allanko/lasernet/lasernet/lasernet.runs/impl_1/.init_design.begin.rst

<?xml version="1.0"?>
<ProcessHandle Version="1" Minor="0">
    <Process Command=".planAhead." Owner="Allan" Host="ALLANKO" Pid="6456">
    </Process>
</ProcessHandle>
