allanko/lasernet/lasernet/lasernet.runs/impl_1/.vivado.begin.rst

<?xml version="1.0"?>
<ProcessHandle Version="1" Minor="0">
    <Process Command="vivado.bat" Owner="Allan" Host="ALLANKO" Pid="4016">
    </Process>
</ProcessHandle>
<?xml version="1.0"?>
<ProcessHandle Version="1" Minor="0">
    <Process Command="vivado.bat" Owner="Allan" Host="ALLANKO" Pid="7376">
    </Process>
</ProcessHandle>
