allanko/lasernet/lasernet/lasernet.ip_user_files/sim_scripts/clk_wiz_0/ies/file_info.txt

xpm_cdc.sv,systemverilog,xil_defaultlib,../../../../../Xilinx/Vivado/2016.3/data/ip/xpm/xpm_cdc/hdl/xpm_cdc.sv,incdir="$ref_dir/../../../ipstatic"incdir="../../../ipstatic"
xpm_VCOMP.vhd,vhdl,xpm,../../../../../Xilinx/Vivado/2016.3/data/ip/xpm/xpm_VCOMP.vhd,incdir="$ref_dir/../../../ipstatic"incdir="../../../ipstatic"
clk_wiz_0_clk_wiz.v,verilog,xil_defaultlib,../../../../lasernet.srcs/sources_1/ip/clk_wiz_0/clk_wiz_0_clk_wiz.v,incdir="$ref_dir/../../../ipstatic"incdir="../../../ipstatic"
clk_wiz_0.v,verilog,xil_defaultlib,../../../../lasernet.srcs/sources_1/ip/clk_wiz_0/clk_wiz_0.v,incdir="$ref_dir/../../../ipstatic"incdir="../../../ipstatic"
glbl.v,Verilog,xil_defaultlib,glbl.v
