allanko/lasernet/documentation/monitor-display.jpg

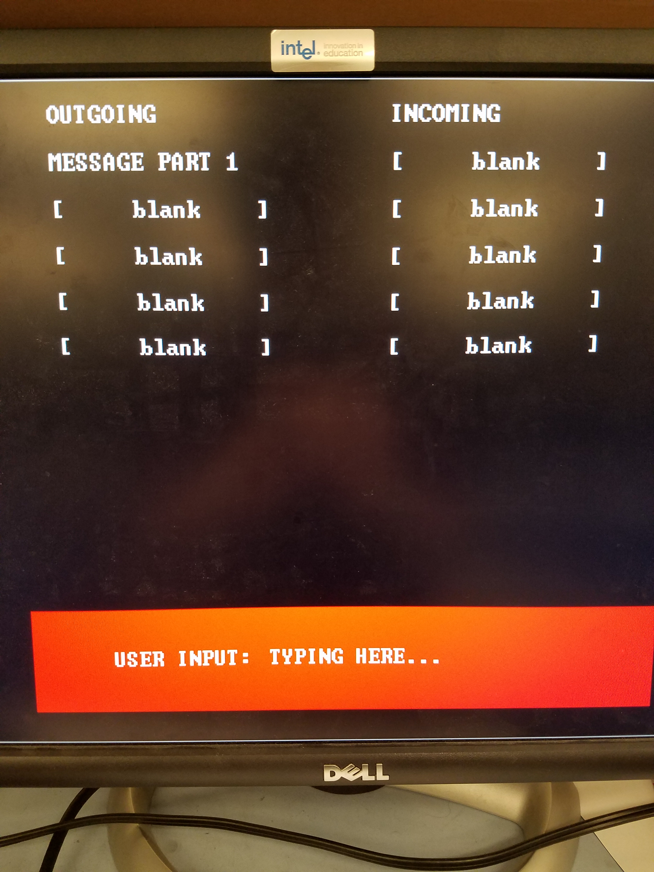
documentation/monitor-display.jpg
