allanko/lasernet/documentation/scratch-work.jpg

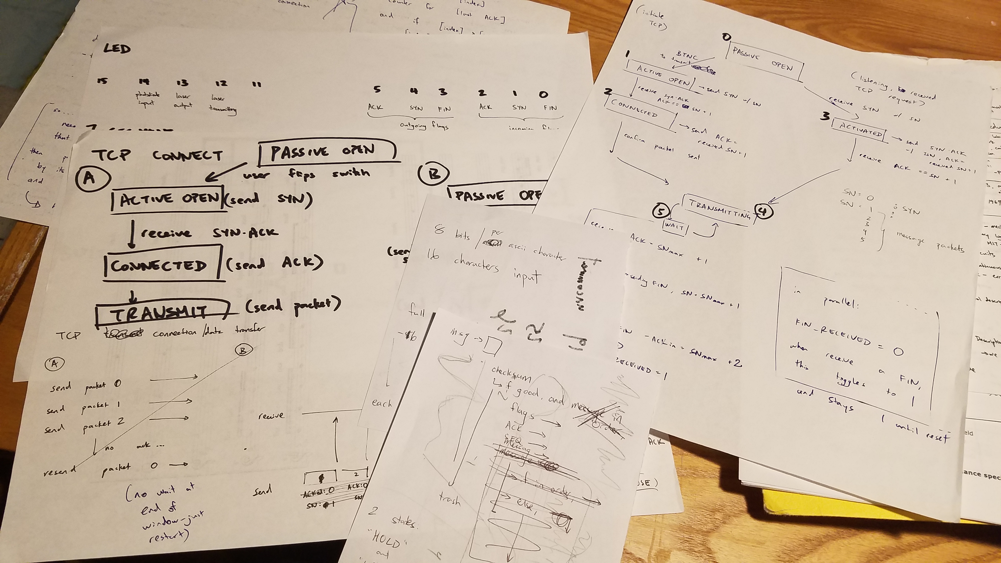
documentation/scratch-work.jpg
