allanko/lasernet/lasernet/lasernet.runs/synth_1/.Xil/labkit_propImpl.xdc

set_property SRC_FILE_INFO {cfile:{C:/Users/Allan/Documents/MIT/FALL 2016/6.111/final project/Nexys4DDR_Master_lab4.xdc} rfile:../../../../Nexys4DDR_Master_lab4.xdc id:1} [current_design]
set_property src_info {type:XDC file:1 line:7 export:INPUT save:INPUT read:READ} [current_design]
set_property -dict { PACKAGE_PIN E3    IOSTANDARD LVCMOS33 } [get_ports { CLK100MHZ }]; #IO_L12P_T1_MRCC_35 Sch=clk100mhz
set_property src_info {type:XDC file:1 line:13 export:INPUT save:INPUT read:READ} [current_design]
set_property -dict { PACKAGE_PIN J15   IOSTANDARD LVCMOS33 } [get_ports { SW[0] }]; #IO_L24N_T3_RS0_15 Sch=sw[0]
set_property src_info {type:XDC file:1 line:14 export:INPUT save:INPUT read:READ} [current_design]
set_property -dict { PACKAGE_PIN L16   IOSTANDARD LVCMOS33 } [get_ports { SW[1] }]; #IO_L3N_T0_DQS_EMCCLK_14 Sch=sw[1]
set_property src_info {type:XDC file:1 line:15 export:INPUT save:INPUT read:READ} [current_design]
set_property -dict { PACKAGE_PIN M13   IOSTANDARD LVCMOS33 } [get_ports { SW[2] }]; #IO_L6N_T0_D08_VREF_14 Sch=sw[2]
set_property src_info {type:XDC file:1 line:16 export:INPUT save:INPUT read:READ} [current_design]
set_property -dict { PACKAGE_PIN R15   IOSTANDARD LVCMOS33 } [get_ports { SW[3] }]; #IO_L13N_T2_MRCC_14 Sch=sw[3]
set_property src_info {type:XDC file:1 line:17 export:INPUT save:INPUT read:READ} [current_design]
set_property -dict { PACKAGE_PIN R17   IOSTANDARD LVCMOS33 } [get_ports { SW[4] }]; #IO_L12N_T1_MRCC_14 Sch=sw[4]
set_property src_info {type:XDC file:1 line:18 export:INPUT save:INPUT read:READ} [current_design]
set_property -dict { PACKAGE_PIN T18   IOSTANDARD LVCMOS33 } [get_ports { SW[5] }]; #IO_L7N_T1_D10_14 Sch=sw[5]
set_property src_info {type:XDC file:1 line:19 export:INPUT save:INPUT read:READ} [current_design]
set_property -dict { PACKAGE_PIN U18   IOSTANDARD LVCMOS33 } [get_ports { SW[6] }]; #IO_L17N_T2_A13_D29_14 Sch=sw[6]
set_property src_info {type:XDC file:1 line:20 export:INPUT save:INPUT read:READ} [current_design]
set_property -dict { PACKAGE_PIN R13   IOSTANDARD LVCMOS33 } [get_ports { SW[7] }]; #IO_L5N_T0_D07_14 Sch=sw[7]
set_property src_info {type:XDC file:1 line:21 export:INPUT save:INPUT read:READ} [current_design]
set_property -dict { PACKAGE_PIN T8    IOSTANDARD LVCMOS18 } [get_ports { SW[8] }]; #IO_L24N_T3_34 Sch=sw[8]
set_property src_info {type:XDC file:1 line:22 export:INPUT save:INPUT read:READ} [current_design]
set_property -dict { PACKAGE_PIN U8    IOSTANDARD LVCMOS18 } [get_ports { SW[9] }]; #IO_25_34 Sch=sw[9]
set_property src_info {type:XDC file:1 line:23 export:INPUT save:INPUT read:READ} [current_design]
set_property -dict { PACKAGE_PIN R16   IOSTANDARD LVCMOS33 } [get_ports { SW[10] }]; #IO_L15P_T2_DQS_RDWR_B_14 Sch=sw[10]
set_property src_info {type:XDC file:1 line:24 export:INPUT save:INPUT read:READ} [current_design]
set_property -dict { PACKAGE_PIN T13   IOSTANDARD LVCMOS33 } [get_ports { SW[11] }]; #IO_L23P_T3_A03_D19_14 Sch=sw[11]
set_property src_info {type:XDC file:1 line:25 export:INPUT save:INPUT read:READ} [current_design]
set_property -dict { PACKAGE_PIN H6    IOSTANDARD LVCMOS33 } [get_ports { SW[12] }]; #IO_L24P_T3_35 Sch=sw[12]
set_property src_info {type:XDC file:1 line:26 export:INPUT save:INPUT read:READ} [current_design]
set_property -dict { PACKAGE_PIN U12   IOSTANDARD LVCMOS33 } [get_ports { SW[13] }]; #IO_L20P_T3_A08_D24_14 Sch=sw[13]
set_property src_info {type:XDC file:1 line:27 export:INPUT save:INPUT read:READ} [current_design]
set_property -dict { PACKAGE_PIN U11   IOSTANDARD LVCMOS33 } [get_ports { SW[14] }]; #IO_L19N_T3_A09_D25_VREF_14 Sch=sw[14]
set_property src_info {type:XDC file:1 line:28 export:INPUT save:INPUT read:READ} [current_design]
set_property -dict { PACKAGE_PIN V10   IOSTANDARD LVCMOS33 } [get_ports { SW[15] }]; #IO_L21P_T3_DQS_14 Sch=sw[15]
set_property src_info {type:XDC file:1 line:33 export:INPUT save:INPUT read:READ} [current_design]
set_property -dict { PACKAGE_PIN H17   IOSTANDARD LVCMOS33 } [get_ports { LED[0] }]; #IO_L18P_T2_A24_15 Sch=led[0]
set_property src_info {type:XDC file:1 line:34 export:INPUT save:INPUT read:READ} [current_design]
set_property -dict { PACKAGE_PIN K15   IOSTANDARD LVCMOS33 } [get_ports { LED[1] }]; #IO_L24P_T3_RS1_15 Sch=led[1]
set_property src_info {type:XDC file:1 line:35 export:INPUT save:INPUT read:READ} [current_design]
set_property -dict { PACKAGE_PIN J13   IOSTANDARD LVCMOS33 } [get_ports { LED[2] }]; #IO_L17N_T2_A25_15 Sch=led[2]
set_property src_info {type:XDC file:1 line:36 export:INPUT save:INPUT read:READ} [current_design]
set_property -dict { PACKAGE_PIN N14   IOSTANDARD LVCMOS33 } [get_ports { LED[3] }]; #IO_L8P_T1_D11_14 Sch=led[3]
set_property src_info {type:XDC file:1 line:37 export:INPUT save:INPUT read:READ} [current_design]
set_property -dict { PACKAGE_PIN R18   IOSTANDARD LVCMOS33 } [get_ports { LED[4] }]; #IO_L7P_T1_D09_14 Sch=led[4]
set_property src_info {type:XDC file:1 line:38 export:INPUT save:INPUT read:READ} [current_design]
set_property -dict { PACKAGE_PIN V17   IOSTANDARD LVCMOS33 } [get_ports { LED[5] }]; #IO_L18N_T2_A11_D27_14 Sch=led[5]
set_property src_info {type:XDC file:1 line:39 export:INPUT save:INPUT read:READ} [current_design]
set_property -dict { PACKAGE_PIN U17   IOSTANDARD LVCMOS33 } [get_ports { LED[6] }]; #IO_L17P_T2_A14_D30_14 Sch=led[6]
set_property src_info {type:XDC file:1 line:40 export:INPUT save:INPUT read:READ} [current_design]
set_property -dict { PACKAGE_PIN U16   IOSTANDARD LVCMOS33 } [get_ports { LED[7] }]; #IO_L18P_T2_A12_D28_14 Sch=led[7]
set_property src_info {type:XDC file:1 line:41 export:INPUT save:INPUT read:READ} [current_design]
set_property -dict { PACKAGE_PIN V16   IOSTANDARD LVCMOS33 } [get_ports { LED[8] }]; #IO_L16N_T2_A15_D31_14 Sch=led[8]
set_property src_info {type:XDC file:1 line:42 export:INPUT save:INPUT read:READ} [current_design]
set_property -dict { PACKAGE_PIN T15   IOSTANDARD LVCMOS33 } [get_ports { LED[9] }]; #IO_L14N_T2_SRCC_14 Sch=led[9]
set_property src_info {type:XDC file:1 line:43 export:INPUT save:INPUT read:READ} [current_design]
set_property -dict { PACKAGE_PIN U14   IOSTANDARD LVCMOS33 } [get_ports { LED[10] }]; #IO_L22P_T3_A05_D21_14 Sch=led[10]
set_property src_info {type:XDC file:1 line:44 export:INPUT save:INPUT read:READ} [current_design]
set_property -dict { PACKAGE_PIN T16   IOSTANDARD LVCMOS33 } [get_ports { LED[11] }]; #IO_L15N_T2_DQS_DOUT_CSO_B_14 Sch=led[11]
set_property src_info {type:XDC file:1 line:45 export:INPUT save:INPUT read:READ} [current_design]
set_property -dict { PACKAGE_PIN V15   IOSTANDARD LVCMOS33 } [get_ports { LED[12] }]; #IO_L16P_T2_CSI_B_14 Sch=led[12]
set_property src_info {type:XDC file:1 line:46 export:INPUT save:INPUT read:READ} [current_design]
set_property -dict { PACKAGE_PIN V14   IOSTANDARD LVCMOS33 } [get_ports { LED[13] }]; #IO_L22N_T3_A04_D20_14 Sch=led[13]
set_property src_info {type:XDC file:1 line:47 export:INPUT save:INPUT read:READ} [current_design]
set_property -dict { PACKAGE_PIN V12   IOSTANDARD LVCMOS33 } [get_ports { LED[14] }]; #IO_L20N_T3_A07_D23_14 Sch=led[14]
set_property src_info {type:XDC file:1 line:48 export:INPUT save:INPUT read:READ} [current_design]
set_property -dict { PACKAGE_PIN V11   IOSTANDARD LVCMOS33 } [get_ports { LED[15] }]; #IO_L21N_T3_DQS_A06_D22_14 Sch=led[15]
set_property src_info {type:XDC file:1 line:50 export:INPUT save:INPUT read:READ} [current_design]
set_property -dict { PACKAGE_PIN R12   IOSTANDARD LVCMOS33 } [get_ports { LED16_B }]; #IO_L5P_T0_D06_14 Sch=led16_b
set_property src_info {type:XDC file:1 line:51 export:INPUT save:INPUT read:READ} [current_design]
set_property -dict { PACKAGE_PIN M16   IOSTANDARD LVCMOS33 } [get_ports { LED16_G }]; #IO_L10P_T1_D14_14 Sch=led16_g
set_property src_info {type:XDC file:1 line:52 export:INPUT save:INPUT read:READ} [current_design]
set_property -dict { PACKAGE_PIN N15   IOSTANDARD LVCMOS33 } [get_ports { LED16_R }]; #IO_L11P_T1_SRCC_14 Sch=led16_r
set_property src_info {type:XDC file:1 line:53 export:INPUT save:INPUT read:READ} [current_design]
set_property -dict { PACKAGE_PIN G14   IOSTANDARD LVCMOS33 } [get_ports { LED17_B }]; #IO_L15N_T2_DQS_ADV_B_15 Sch=led17_b
set_property src_info {type:XDC file:1 line:54 export:INPUT save:INPUT read:READ} [current_design]
set_property -dict { PACKAGE_PIN R11   IOSTANDARD LVCMOS33 } [get_ports { LED17_G }]; #IO_0_14 Sch=led17_g
set_property src_info {type:XDC file:1 line:55 export:INPUT save:INPUT read:READ} [current_design]
set_property -dict { PACKAGE_PIN N16   IOSTANDARD LVCMOS33 } [get_ports { LED17_R }]; #IO_L11N_T1_SRCC_14 Sch=led17_r
set_property src_info {type:XDC file:1 line:60 export:INPUT save:INPUT read:READ} [current_design]
set_property -dict { PACKAGE_PIN T10   IOSTANDARD LVCMOS33 } [get_ports { SEG[0] }]; #IO_L24N_T3_A00_D16_14 Sch=ca
set_property src_info {type:XDC file:1 line:61 export:INPUT save:INPUT read:READ} [current_design]
set_property -dict { PACKAGE_PIN R10   IOSTANDARD LVCMOS33 } [get_ports { SEG[1] }]; #IO_25_14 Sch=cb
set_property src_info {type:XDC file:1 line:62 export:INPUT save:INPUT read:READ} [current_design]
set_property -dict { PACKAGE_PIN K16   IOSTANDARD LVCMOS33 } [get_ports { SEG[2] }]; #IO_25_15 Sch=cc
set_property src_info {type:XDC file:1 line:63 export:INPUT save:INPUT read:READ} [current_design]
set_property -dict { PACKAGE_PIN K13   IOSTANDARD LVCMOS33 } [get_ports { SEG[3] }]; #IO_L17P_T2_A26_15 Sch=cd
set_property src_info {type:XDC file:1 line:64 export:INPUT save:INPUT read:READ} [current_design]
set_property -dict { PACKAGE_PIN P15   IOSTANDARD LVCMOS33 } [get_ports { SEG[4] }]; #IO_L13P_T2_MRCC_14 Sch=ce
set_property src_info {type:XDC file:1 line:65 export:INPUT save:INPUT read:READ} [current_design]
set_property -dict { PACKAGE_PIN T11   IOSTANDARD LVCMOS33 } [get_ports { SEG[5] }]; #IO_L19P_T3_A10_D26_14 Sch=cf
set_property src_info {type:XDC file:1 line:66 export:INPUT save:INPUT read:READ} [current_design]
set_property -dict { PACKAGE_PIN L18   IOSTANDARD LVCMOS33 } [get_ports { SEG[6] }]; #IO_L4P_T0_D04_14 Sch=cg
set_property src_info {type:XDC file:1 line:68 export:INPUT save:INPUT read:READ} [current_design]
set_property -dict { PACKAGE_PIN H15   IOSTANDARD LVCMOS33 } [get_ports { SEG[7] }]; #IO_L19N_T3_A21_VREF_15 Sch=dp
set_property src_info {type:XDC file:1 line:70 export:INPUT save:INPUT read:READ} [current_design]
set_property -dict { PACKAGE_PIN J17   IOSTANDARD LVCMOS33 } [get_ports { AN[0] }]; #IO_L23P_T3_FOE_B_15 Sch=an[0]
set_property src_info {type:XDC file:1 line:71 export:INPUT save:INPUT read:READ} [current_design]
set_property -dict { PACKAGE_PIN J18   IOSTANDARD LVCMOS33 } [get_ports { AN[1] }]; #IO_L23N_T3_FWE_B_15 Sch=an[1]
set_property src_info {type:XDC file:1 line:72 export:INPUT save:INPUT read:READ} [current_design]
set_property -dict { PACKAGE_PIN T9    IOSTANDARD LVCMOS33 } [get_ports { AN[2] }]; #IO_L24P_T3_A01_D17_14 Sch=an[2]
set_property src_info {type:XDC file:1 line:73 export:INPUT save:INPUT read:READ} [current_design]
set_property -dict { PACKAGE_PIN J14   IOSTANDARD LVCMOS33 } [get_ports { AN[3] }]; #IO_L19P_T3_A22_15 Sch=an[3]
set_property src_info {type:XDC file:1 line:74 export:INPUT save:INPUT read:READ} [current_design]
set_property -dict { PACKAGE_PIN P14   IOSTANDARD LVCMOS33 } [get_ports { AN[4] }]; #IO_L8N_T1_D12_14 Sch=an[4]
set_property src_info {type:XDC file:1 line:75 export:INPUT save:INPUT read:READ} [current_design]
set_property -dict { PACKAGE_PIN T14   IOSTANDARD LVCMOS33 } [get_ports { AN[5] }]; #IO_L14P_T2_SRCC_14 Sch=an[5]
set_property src_info {type:XDC file:1 line:76 export:INPUT save:INPUT read:READ} [current_design]
set_property -dict { PACKAGE_PIN K2    IOSTANDARD LVCMOS33 } [get_ports { AN[6] }]; #IO_L23P_T3_35 Sch=an[6]
set_property src_info {type:XDC file:1 line:77 export:INPUT save:INPUT read:READ} [current_design]
set_property -dict { PACKAGE_PIN U13   IOSTANDARD LVCMOS33 } [get_ports { AN[7] }]; #IO_L23N_T3_A02_D18_14 Sch=an[7]
set_property src_info {type:XDC file:1 line:84 export:INPUT save:INPUT read:READ} [current_design]
set_property -dict { PACKAGE_PIN N17   IOSTANDARD LVCMOS33 } [get_ports { BTNC }]; #IO_L9P_T1_DQS_14 Sch=btnc
set_property src_info {type:XDC file:1 line:85 export:INPUT save:INPUT read:READ} [current_design]
set_property -dict { PACKAGE_PIN M18   IOSTANDARD LVCMOS33 } [get_ports { BTNU }]; #IO_L4N_T0_D05_14 Sch=btnu
set_property src_info {type:XDC file:1 line:86 export:INPUT save:INPUT read:READ} [current_design]
set_property -dict { PACKAGE_PIN P17   IOSTANDARD LVCMOS33 } [get_ports { BTNL }]; #IO_L12P_T1_MRCC_14 Sch=btnl
set_property src_info {type:XDC file:1 line:87 export:INPUT save:INPUT read:READ} [current_design]
set_property -dict { PACKAGE_PIN M17   IOSTANDARD LVCMOS33 } [get_ports { BTNR }]; #IO_L10N_T1_D15_14 Sch=btnr
set_property src_info {type:XDC file:1 line:88 export:INPUT save:INPUT read:READ} [current_design]
set_property -dict { PACKAGE_PIN P18   IOSTANDARD LVCMOS33 } [get_ports { BTND }]; #IO_L9N_T1_DQS_D13_14 Sch=btnd
set_property src_info {type:XDC file:1 line:96 export:INPUT save:INPUT read:READ} [current_design]
set_property -dict { PACKAGE_PIN C17   IOSTANDARD LVCMOS33 } [get_ports { JA[0] }]; #IO_L20N_T3_A19_15 Sch=ja[1]
set_property src_info {type:XDC file:1 line:97 export:INPUT save:INPUT read:READ} [current_design]
set_property -dict { PACKAGE_PIN D18   IOSTANDARD LVCMOS33 } [get_ports { JA[1] }]; #IO_L21N_T3_DQS_A18_15 Sch=ja[2]
set_property src_info {type:XDC file:1 line:98 export:INPUT save:INPUT read:READ} [current_design]
set_property -dict { PACKAGE_PIN E18   IOSTANDARD LVCMOS33 } [get_ports { JA[2] }]; #IO_L21P_T3_DQS_15 Sch=ja[3]
set_property src_info {type:XDC file:1 line:99 export:INPUT save:INPUT read:READ} [current_design]
set_property -dict { PACKAGE_PIN G17   IOSTANDARD LVCMOS33 } [get_ports { JA[3] }]; #IO_L18N_T2_A23_15 Sch=ja[4]
set_property src_info {type:XDC file:1 line:100 export:INPUT save:INPUT read:READ} [current_design]
set_property -dict { PACKAGE_PIN D17   IOSTANDARD LVCMOS33 } [get_ports { JA[4] }]; #IO_L16N_T2_A27_15 Sch=ja[7]
set_property src_info {type:XDC file:1 line:101 export:INPUT save:INPUT read:READ} [current_design]
set_property -dict { PACKAGE_PIN E17   IOSTANDARD LVCMOS33 } [get_ports { JA[5] }]; #IO_L16P_T2_A28_15 Sch=ja[8]
set_property src_info {type:XDC file:1 line:102 export:INPUT save:INPUT read:READ} [current_design]
set_property -dict { PACKAGE_PIN F18   IOSTANDARD LVCMOS33 } [get_ports { JA[6] }]; #IO_L22N_T3_A16_15 Sch=ja[9]
set_property src_info {type:XDC file:1 line:103 export:INPUT save:INPUT read:READ} [current_design]
set_property -dict { PACKAGE_PIN G18   IOSTANDARD LVCMOS33 } [get_ports { JA[7] }]; #IO_L22P_T3_A17_15 Sch=ja[10]
set_property src_info {type:XDC file:1 line:156 export:INPUT save:INPUT read:READ} [current_design]
set_property -dict { PACKAGE_PIN A3    IOSTANDARD LVCMOS33 } [get_ports { VGA_R[0] }]; #IO_L8N_T1_AD14N_35 Sch=vga_r[0]
set_property src_info {type:XDC file:1 line:157 export:INPUT save:INPUT read:READ} [current_design]
set_property -dict { PACKAGE_PIN B4    IOSTANDARD LVCMOS33 } [get_ports { VGA_R[1] }]; #IO_L7N_T1_AD6N_35 Sch=vga_r[1]
set_property src_info {type:XDC file:1 line:158 export:INPUT save:INPUT read:READ} [current_design]
set_property -dict { PACKAGE_PIN C5    IOSTANDARD LVCMOS33 } [get_ports { VGA_R[2] }]; #IO_L1N_T0_AD4N_35 Sch=vga_r[2]
set_property src_info {type:XDC file:1 line:159 export:INPUT save:INPUT read:READ} [current_design]
set_property -dict { PACKAGE_PIN A4    IOSTANDARD LVCMOS33 } [get_ports { VGA_R[3] }]; #IO_L8P_T1_AD14P_35 Sch=vga_r[3]
set_property src_info {type:XDC file:1 line:161 export:INPUT save:INPUT read:READ} [current_design]
set_property -dict { PACKAGE_PIN C6    IOSTANDARD LVCMOS33 } [get_ports { VGA_G[0] }]; #IO_L1P_T0_AD4P_35 Sch=vga_g[0]
set_property src_info {type:XDC file:1 line:162 export:INPUT save:INPUT read:READ} [current_design]
set_property -dict { PACKAGE_PIN A5    IOSTANDARD LVCMOS33 } [get_ports { VGA_G[1] }]; #IO_L3N_T0_DQS_AD5N_35 Sch=vga_g[1]
set_property src_info {type:XDC file:1 line:163 export:INPUT save:INPUT read:READ} [current_design]
set_property -dict { PACKAGE_PIN B6    IOSTANDARD LVCMOS33 } [get_ports { VGA_G[2] }]; #IO_L2N_T0_AD12N_35 Sch=vga_g[2]
set_property src_info {type:XDC file:1 line:164 export:INPUT save:INPUT read:READ} [current_design]
set_property -dict { PACKAGE_PIN A6    IOSTANDARD LVCMOS33 } [get_ports { VGA_G[3] }]; #IO_L3P_T0_DQS_AD5P_35 Sch=vga_g[3]
set_property src_info {type:XDC file:1 line:166 export:INPUT save:INPUT read:READ} [current_design]
set_property -dict { PACKAGE_PIN B7    IOSTANDARD LVCMOS33 } [get_ports { VGA_B[0] }]; #IO_L2P_T0_AD12P_35 Sch=vga_b[0]
set_property src_info {type:XDC file:1 line:167 export:INPUT save:INPUT read:READ} [current_design]
set_property -dict { PACKAGE_PIN C7    IOSTANDARD LVCMOS33 } [get_ports { VGA_B[1] }]; #IO_L4N_T0_35 Sch=vga_b[1]
set_property src_info {type:XDC file:1 line:168 export:INPUT save:INPUT read:READ} [current_design]
set_property -dict { PACKAGE_PIN D7    IOSTANDARD LVCMOS33 } [get_ports { VGA_B[2] }]; #IO_L6N_T0_VREF_35 Sch=vga_b[2]
set_property src_info {type:XDC file:1 line:169 export:INPUT save:INPUT read:READ} [current_design]
set_property -dict { PACKAGE_PIN D8    IOSTANDARD LVCMOS33 } [get_ports { VGA_B[3] }]; #IO_L4P_T0_35 Sch=vga_b[3]
set_property src_info {type:XDC file:1 line:171 export:INPUT save:INPUT read:READ} [current_design]
set_property -dict { PACKAGE_PIN B11   IOSTANDARD LVCMOS33 } [get_ports { VGA_HS }]; #IO_L4P_T0_15 Sch=vga_hs
set_property src_info {type:XDC file:1 line:172 export:INPUT save:INPUT read:READ} [current_design]
set_property -dict { PACKAGE_PIN B12   IOSTANDARD LVCMOS33 } [get_ports { VGA_VS }]; #IO_L3N_T0_DQS_AD1N_15 Sch=vga_vs
set_property src_info {type:XDC file:1 line:219 export:INPUT save:INPUT read:READ} [current_design]
set_property -dict { PACKAGE_PIN D4    IOSTANDARD LVCMOS33 } [get_ports { UART_RXD_OUT }]; #IO_L11N_T1_SRCC_35 Sch=uart_rxd_out
set_property src_info {type:XDC file:1 line:225 export:INPUT save:INPUT read:READ} [current_design]
set_property -dict { PACKAGE_PIN F4    IOSTANDARD LVCMOS33 } [get_ports { PS2_CLK }]; #IO_L13P_T2_MRCC_35 Sch=ps2_clk
set_property src_info {type:XDC file:1 line:226 export:INPUT save:INPUT read:READ} [current_design]
set_property -dict { PACKAGE_PIN B2    IOSTANDARD LVCMOS33 } [get_ports { PS2_DATA }]; #IO_L10N_T1_AD15N_35 Sch=ps2_data
