allanko/lasernet/(commit log)

2017-01-17 fix indexing on incoming message display
    [receivepacket.v]
2017-01-17 fix incoming message indexing
    [nexys-wrapper.v, receivepacket.v]
2017-01-17 fix incoming SN updating
    [receivepacket.v]
2017-01-17 tweak resets in tx and rx modules
    [serial_rx.v, serial_tx.v]
2017-01-17 add timer to fin_wait
2017-01-17 laser connection working
